seojinhg/shipguard/poster/ShipGuard_Poster_v3.png

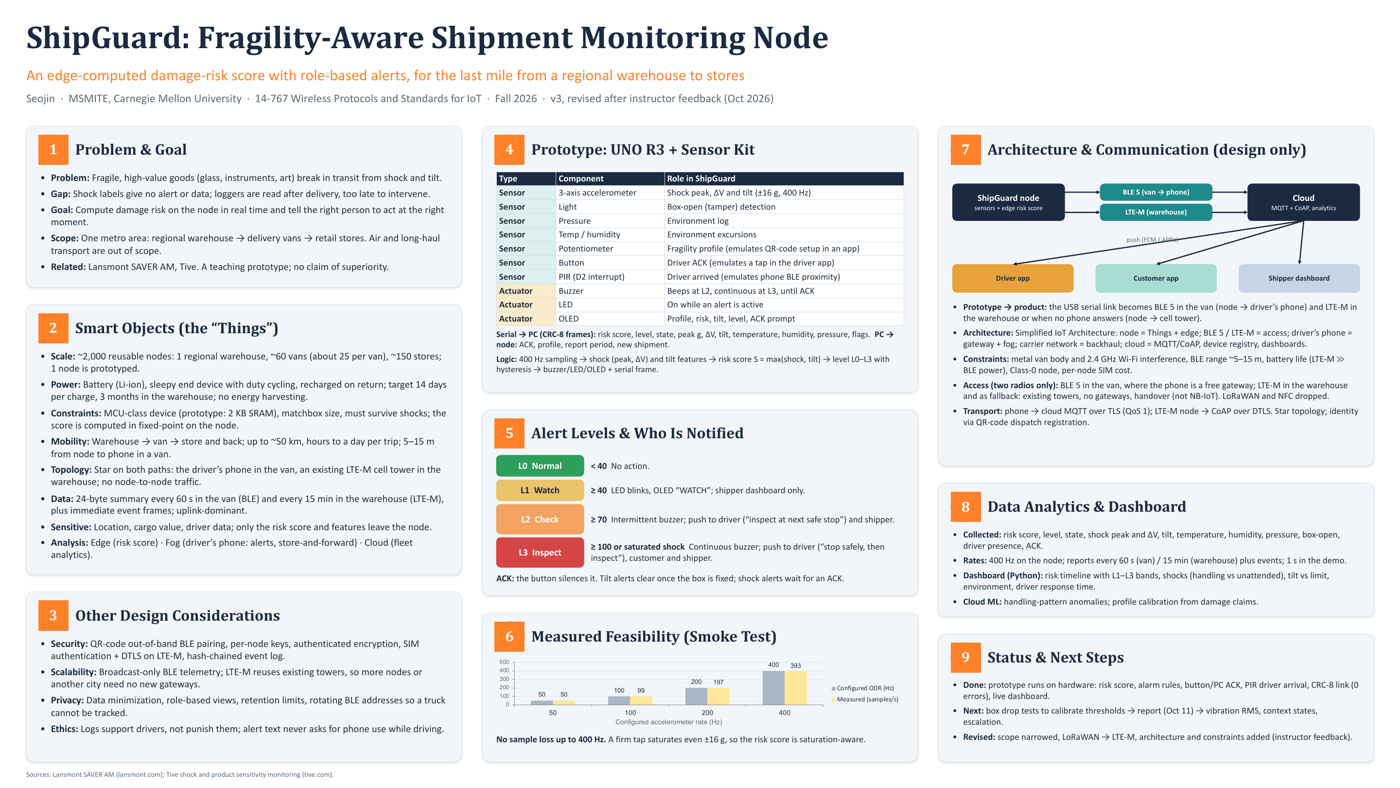
poster/ShipGuard_Poster_v3.png
